gabxelz/EXSU-620---P1---Blood-in-the-drain/docs/photos/README.md

# Build log (photos)

Photos the team took while building the Drain Optics bench prototype, in build order.

| # | Photo | What it shows |
|---|---|---|
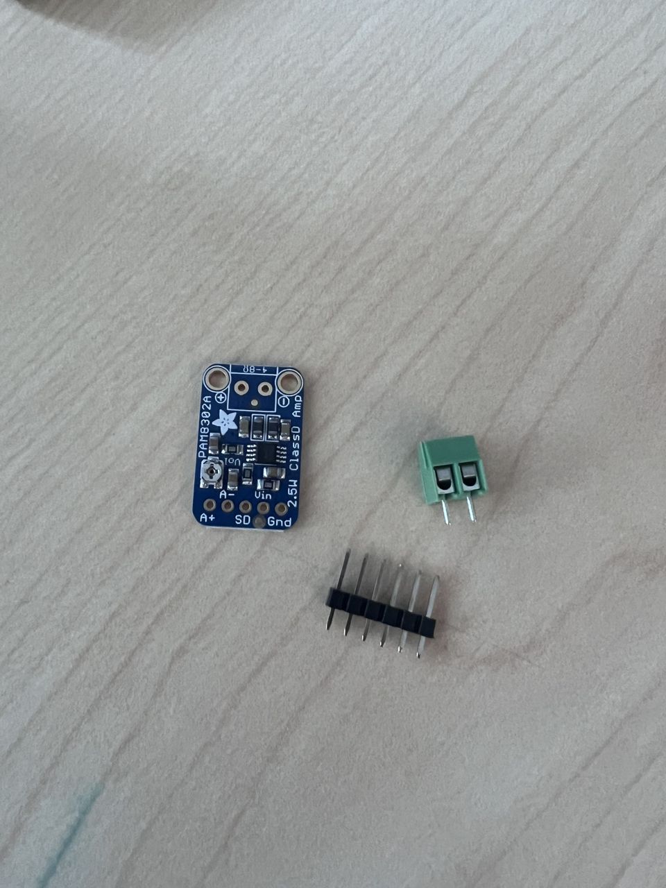
[picture p4: docs/photos/01-pam8302-amp-parts.jpg]
| 1 |  | PAM8302 amplifier as it comes in the kit, with its screw terminal and header pins before soldering. |
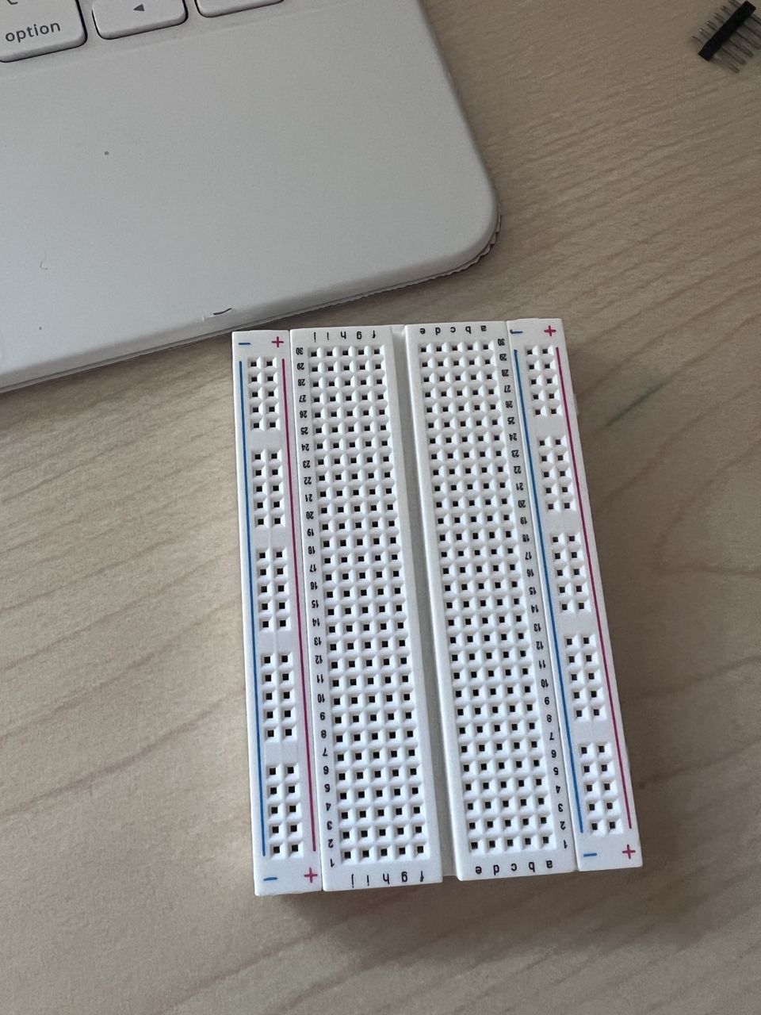
[picture p5: docs/photos/02-breadboard.jpg]
| 2 |  | The half-size breadboard used for power rails, the LED resistor, the button and the amp. |
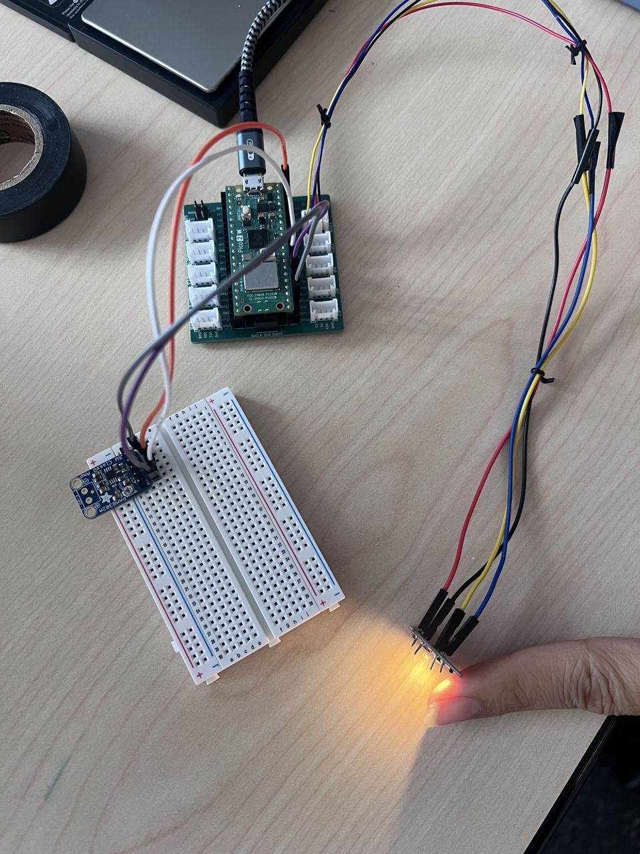
[picture p6: docs/photos/03-first-wiring-led-test.jpg]
| 3 |  | First wiring: Pico 2 W on the Grove shield, colour sensor on jumpers, white LED lit for a light test. |
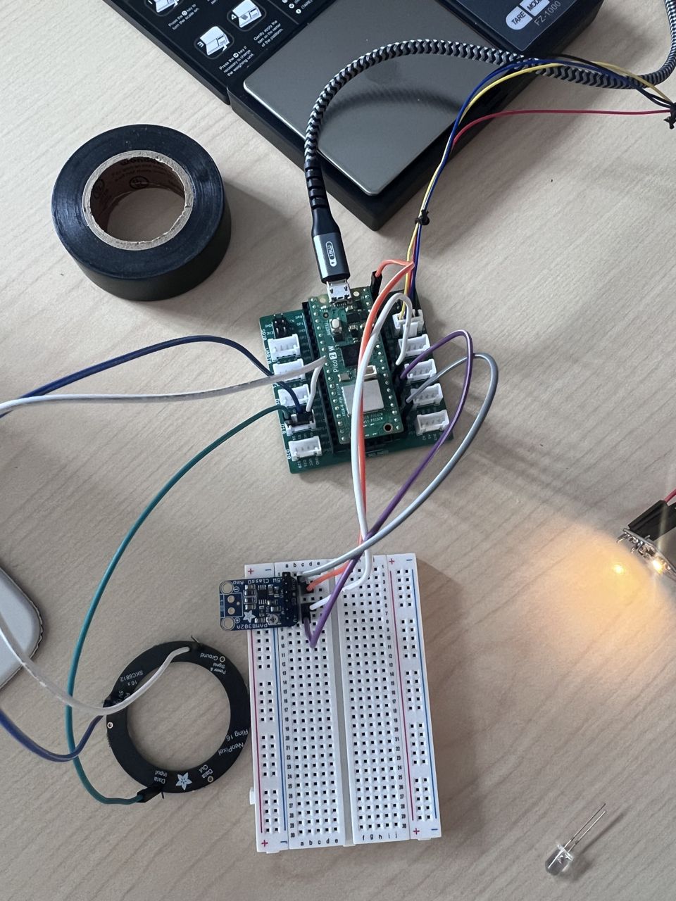
[picture p7: docs/photos/04-pico-sensor-ring-wired.jpg]
| 4 |  | Pico, colour sensor and NeoPixel ring wired together on the bench. |
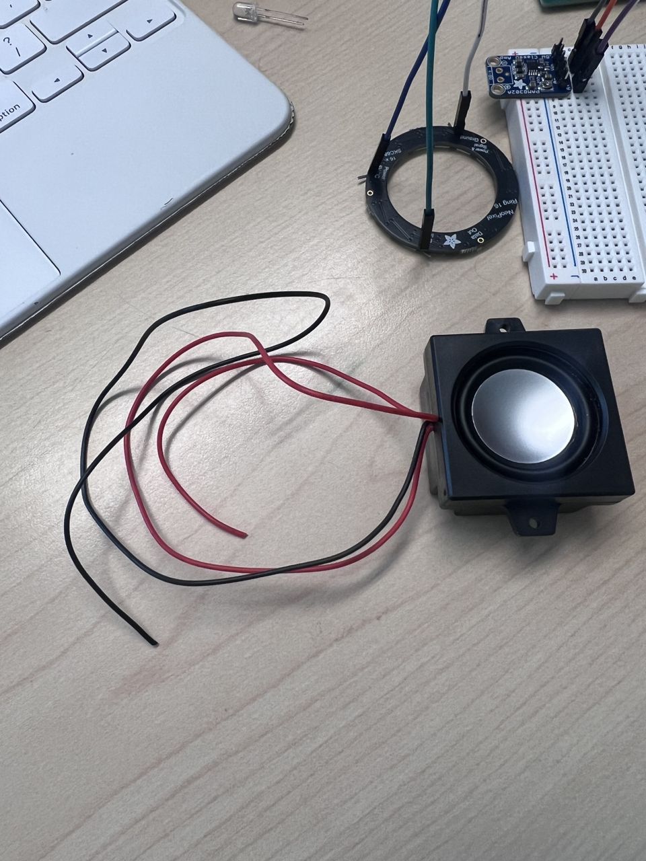
[picture p8: docs/photos/05-speaker-and-neopixel-ring.jpg]
| 5 |  | 8 Ω speaker with its leads, next to the NeoPixel Ring 16 used for the alarm light. |
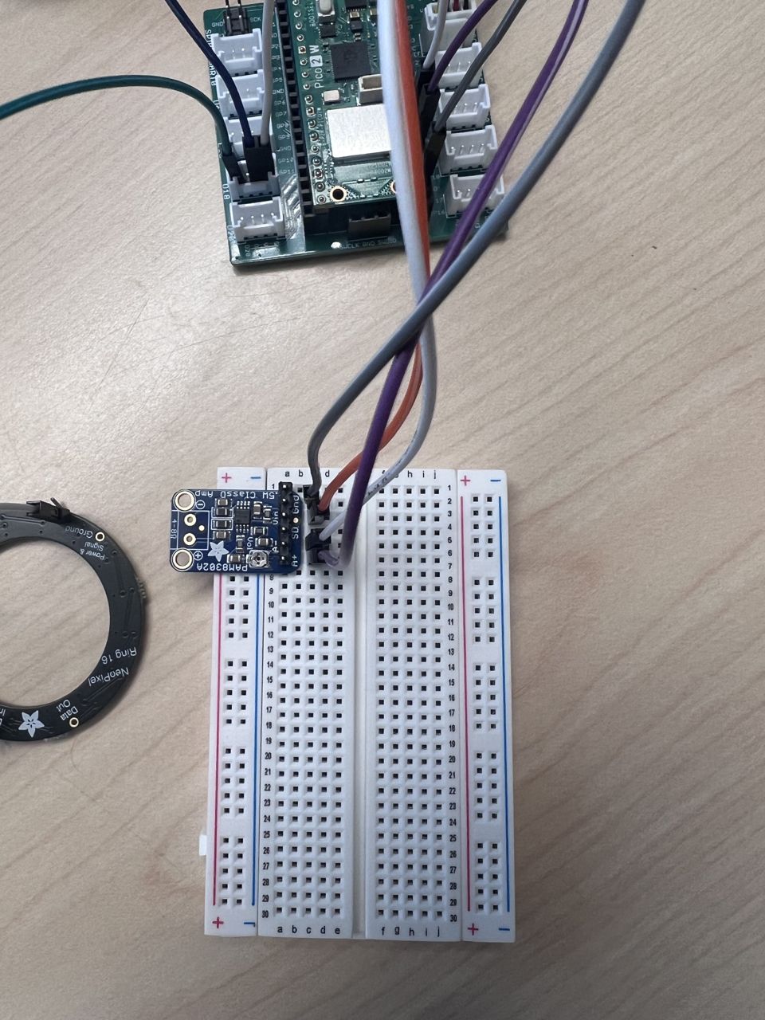
[picture p9: docs/photos/06-amp-on-breadboard.jpg]
| 6 |  | PAM8302 amp placed on the breadboard. |
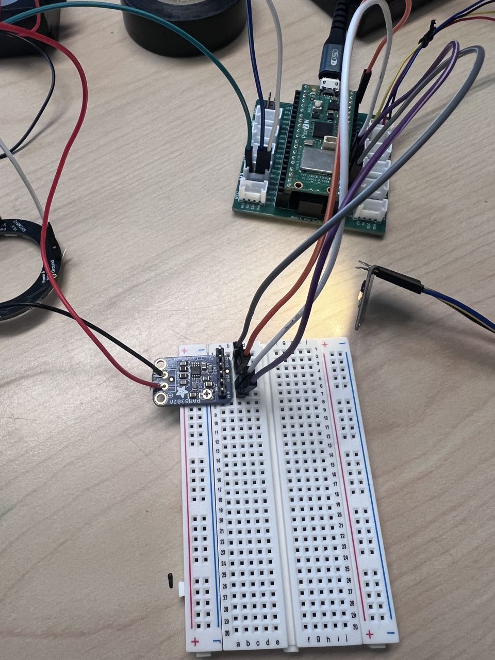
[picture p10: docs/photos/07-amp-wired-to-pico.jpg]
| 7 |  | Amp wired to the Pico: A+ to GP20, Vin to VBUS, grounds to the rail. |
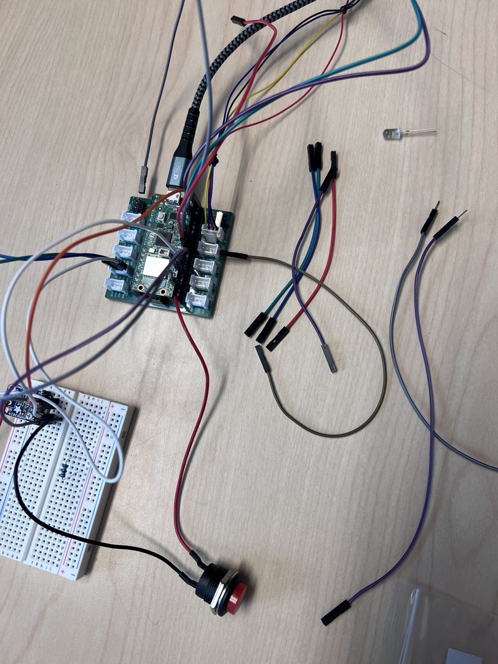
[picture p11: docs/photos/08-ack-button-and-led-wiring.jpg]
| 8 |  | Acknowledge button (GP16 to GND) and white LED leads added. |
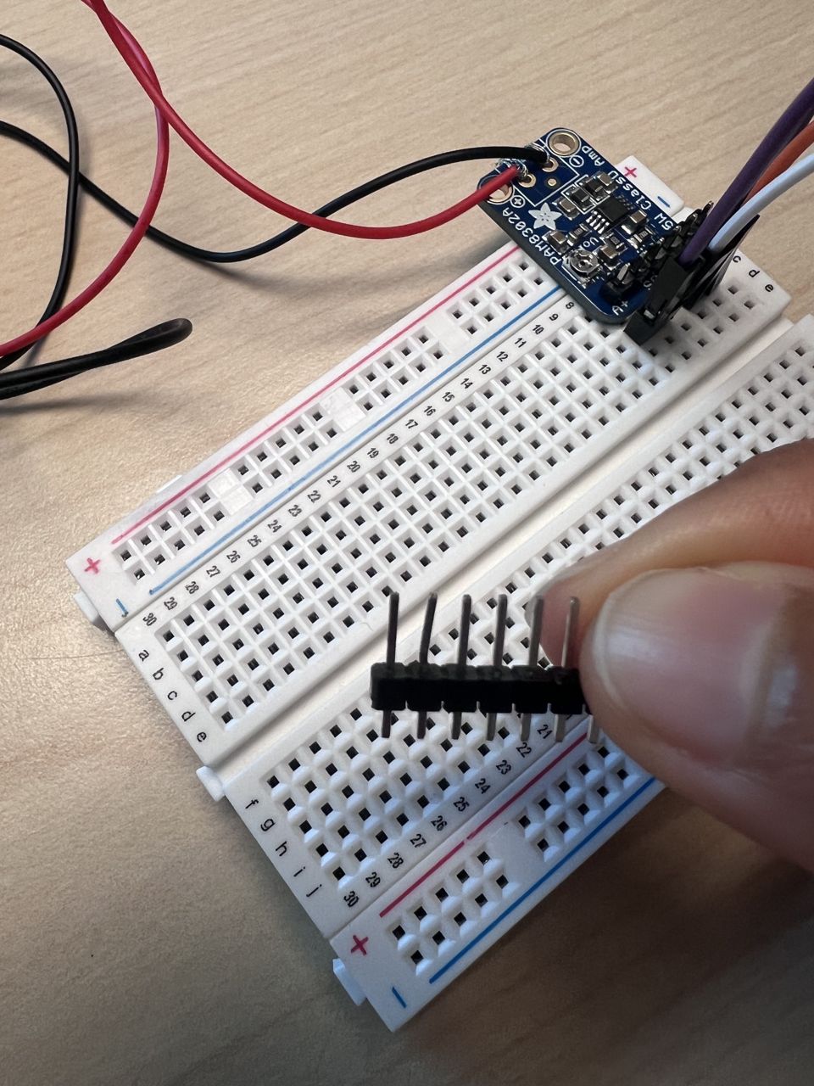
[picture p12: docs/photos/09-soldering-amp-header.jpg]
| 9 |  | Fitting the header pins to the amp for soldering. |
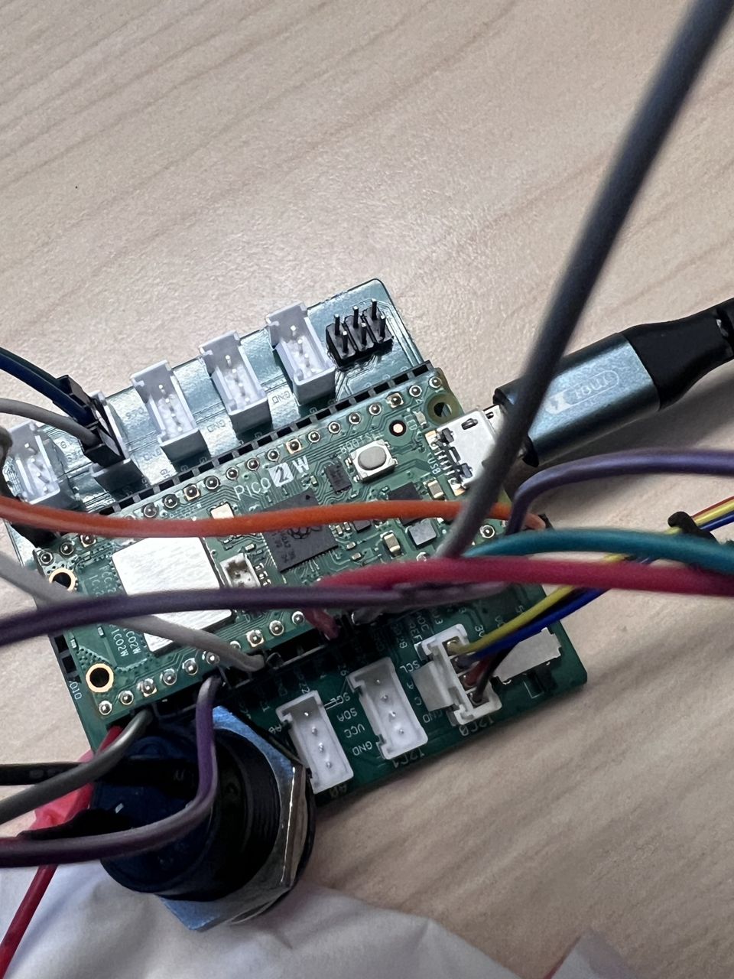
[picture p13: docs/photos/10-pico-grove-shield-closeup.jpg]
| 10 |  | Close-up of the Pico 2 W on the Grove shield with all leads plugged in. |
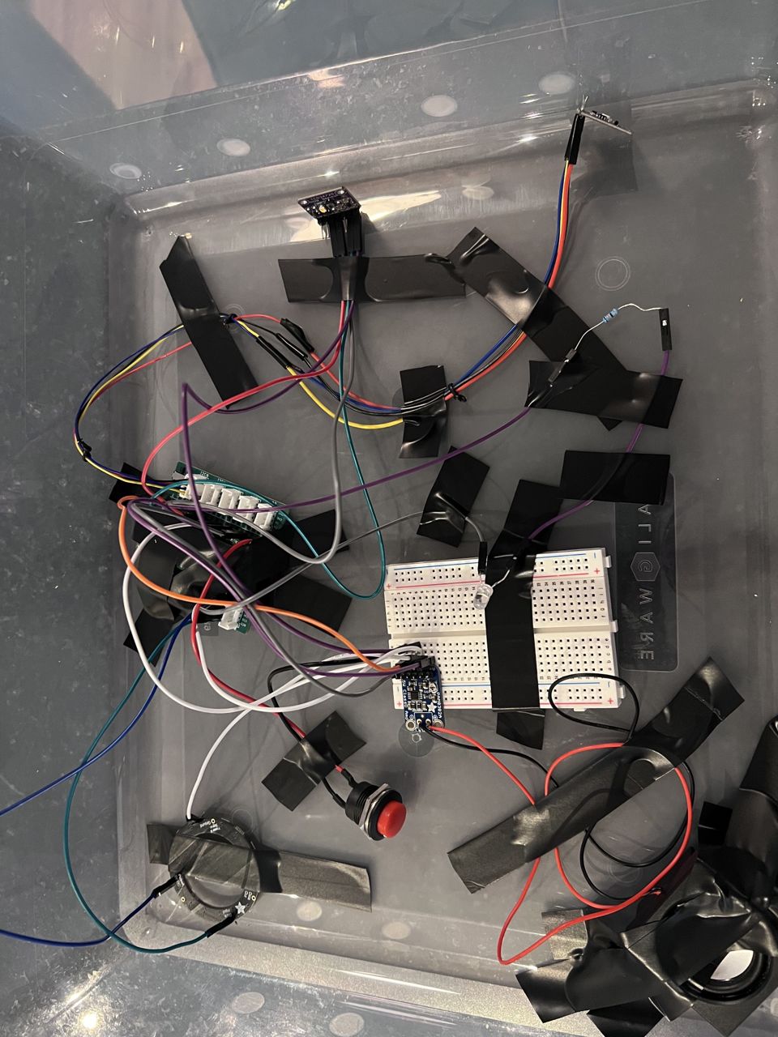
[picture p14: docs/photos/11-parts-in-test-box.jpg]
| 11 |  | Everything taped inside a clear test box before the printed case. |
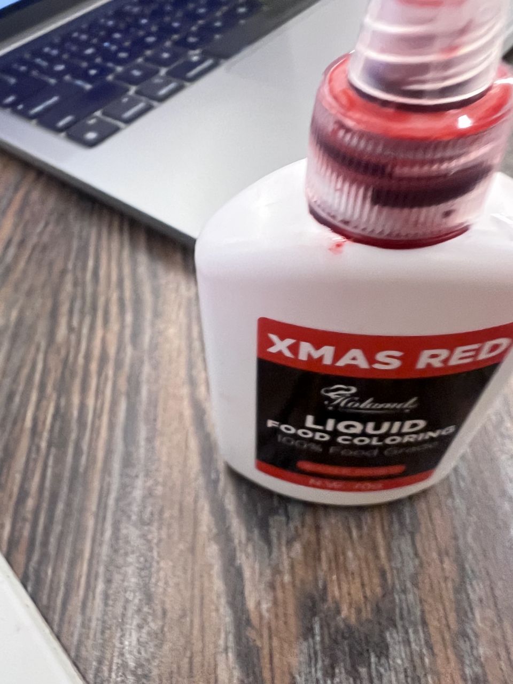
[picture p15: docs/photos/12-red-food-colouring.jpg]
| 12 |  | Red food colouring used as the blood stand-in for the calibration mixes. |
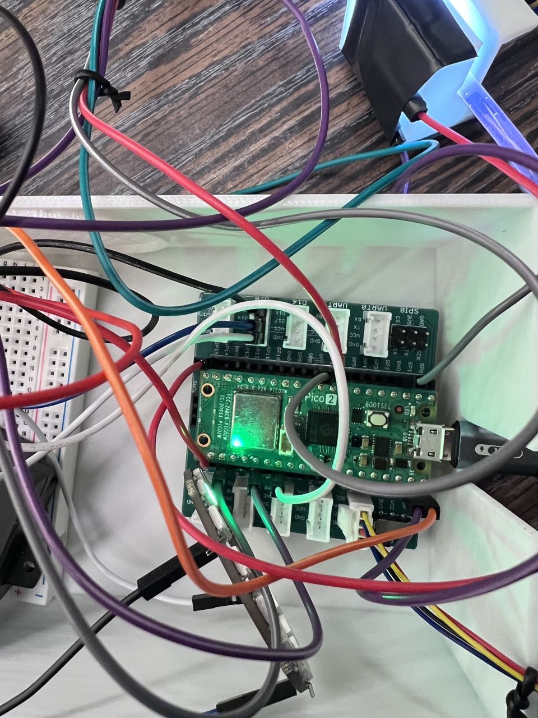
[picture p16: docs/photos/13-final-wiring-powered.jpg]
| 13 |  | Final wiring powered over USB in the case. |
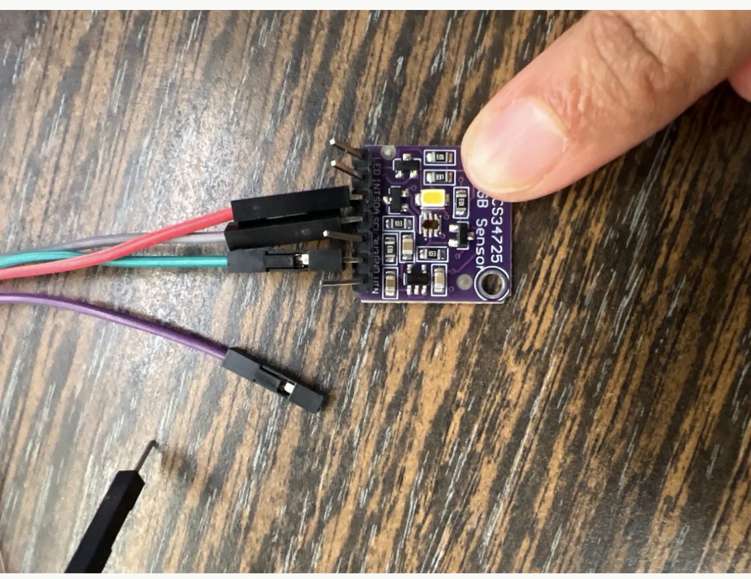
[picture p17: docs/photos/14-tcs34725-sensor.jpg]
| 14 |  | TCS34725 colour sensor with its jumper leads. |
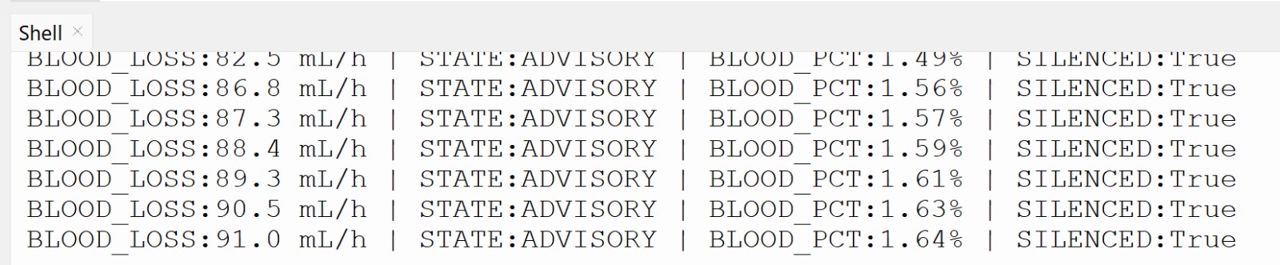
[picture p18: docs/photos/15-serial-output-advisory.jpg]
| 15 |  | Serial output in Thonny during a bench run: about 1.5 % blood, ADVISORY state, alarm silenced by the button. This run used the team's earlier script, which turns % blood into mL/h with a fixed factor rather than a measured flow. |
| 16 |  | Full bench rig: dyed fluid running through the IV tubing and the printed tube clip (right), electronics in the printed case, NeoPixel ring red for CRITICAL. |
| 17 |  | Software group's dashboard (`localhost:5000`): live blood-loss chart in mL/h, blood concentration (1.91 %) and alarm-silence status. |
| 18 |  | Notification path: the DrainOptics Telegram bot sends a CRITICAL alert (103.7 mL/h, 1.87 % blood) to a registered phone. |

## Videos

- [`../videos/demo-device-normal-to-advisory.mp4`](../videos/demo-device-normal-to-advisory.mp4) (56 s): the monitor script running in Thonny, the sensor clip on the tubing, and the output moving from NORMAL to ADVISORY with the ring and speaker responding. Audio is filtered so only the alarm beeps remain (from about 0:30).
- [`../videos/demo-dashboard-live.mp4`](../videos/demo-dashboard-live.mp4) (17 s): the live dashboard on the laptop updating as the fluid in the tube changes.
