gabxelz/EXSU-620---P1---Blood-in-the-drain/report/Blood_in_the_Drain_EXSU620_Report_filled.docx

Drain Optics: Blood in the drain, measured

Group 1

EXSU620

Device

Measurand: Light Absorbance

Reference: Pocket scale, 0.1 g

Status: bench prototype (dyed-water phantom), two-sensor build running monitor_2sensor.py; verification tests in progress.

Section 1: Clinical Requirements, as issued

ID | Requirement
CR-1 | Blood loss through the drain shall be reported as a quantity in millilitres per hour, not as a colour word, and updated at least once a minute
CR-2 | The surgical team shall be alerted when the estimated loss rate exceeds 100mL per hour, or doubles within 30 minutes, whichever happens first
CR-3 | A fouled optical window, an empty line or a failed lamp shall never present as low blood loss
CR-4 | Every shift shall have a cumulative loss figure and a rate trend available at handover and at ward round

Section 2: Engineering Requirements

ID | Traces to | Requirement | Acceptance Criteria
ER-1 | CR-1, CR-3 | Optical reading is stable and immune to room light: room lights on/off and a phone torch at 30 cm change the reading by less than 0.1 % blood. | 5 trials per light condition with clear water and a 1 % mix: every change < 0.1 % blood.
ER-2 | CR-1 | Estimate drain flow in mL/h by counting drops in the drip chamber; range 30-600 mL/h (10-200 drops/min at 20 drops/mL), averaged over 60 s, accuracy ±10 %. | 3 clamp settings x 3 runs of 5 min: mean flow within ±10 % of the weighed collection (1 g = 1 mL).
ER-3 | CR-1 | Report blood loss rate in mL/h (% blood / 100 x flow), and refresh it at least once every 60 s. | Output at least 1 line/s; step from clear water to a 1 % mix reaches 90 % of final value within 60 s, 3 of 3 trials.
ER-4 | CR-2 | Raise an advisory when the estimated rate stays above 100 mL/h for 5 min (amber ring, 3 pulses); clear after 10 min below. | Replayed and live scenarios: advisory raised within 60 s of the 5-min condition, 5 of 5; no alarm in 30 min below 80 mL/h.
ER-5 | CR-2 | Raise a critical alarm when the rate at least doubles within 30 min (red ring, 10 pulses), latched until acknowledged and back in range. | Doubling scenario 5 times: critical raised within 60 s, 5 of 5; stays latched until ack press and rate back in range.
ER-6 | CR-3 | Technical alarm (never low blood loss) for: static line (no drop for 10 s), failed lamp, empty/air-filled tube, saturation and fouled window; raised within 15 s. | Clamp shut 10 times and each optical fault induced 5 times: 100 % shown as a technical alarm within 15 s; 0 false alarms in 30 min at 30 mL/h.
ER-7 | CR-1 | Blood concentration from the green/red ratio: range 0-2 % blood (dye analogue), one reading every ≤ 0.25 s, accuracy ±0.25 % blood. | 3 blind mixes (0.5, 1.0, 1.5 %), 3 readings of 30 s each: every mean within ±0.25 % of the true value.
ER-8 | CR-4 | Log every reading with a timestamp; give cumulative blood volume for the shift (±15 %) and a rate trend of the last 12 h. | 1 h run with a known mix: logged cumulative blood within ±15 % of collected volume x known %; trend shows the full hour.

Section 3: System Design

Architecture, sensing approach, alarm rules, data model, and the alternatives that were rejected and why

Option Considered | Decision | Reason
One colour sensor with a hand-entered flow | Rejected | Colour alone cannot give mL/h: a slow, very bloody drain and a fast, lightly bloody one look the same; a typed flow goes stale when the clamp moves.
Second TCS34725 counting drops in the drip chamber | Chosen | Gives live flow in mL/h from the IV set's drop factor, and a missing drop is a direct test for a clotted or empty line (CR-3). Same kit sensor.
Pocket scale under the bag as the live flow channel | Rejected | The project card forbids the reference instrument as a live channel; the scale is used only for dilutions and flow checks.
Cuvette holder (sample taken off the line) | Rejected | Needs manual sampling, so no continuous reading; replaced by a printed flow-through tube clip.
NeoPixel pixel as the light source | Rejected | The ring is the alarm indicator; a separate white LED on GP15 lights the tube.
I2C multiplexer for two sensors with the same address (0x29) | Rejected | Not in the kit; sensor 2 runs on its own software I2C bus (GP6/GP7).
Change in absorbance per minute from one sensor as the rate | Rejected | Measures how fast the colour changes, not how much fluid flows; reads 0 for steady bleeding.

Section 4: Component, module and system chart

Components grouped into modules, every interface named with its signal, direction and range

Section 5: Interfaces

ID | Between | Signal and Protocol | Kind
IF-1 | Sensor 1 (tube clip) -> Pico | I2C0, GP8 SDA / GP9 SCL, 100 kHz, address 0x29; R, G, B, C counts 0-65 535 per 101 ms | Digital, input
IF-2 | Sensor 2 (drip chamber) -> Pico | Software I2C, GP6 SDA / GP7 SCL, 400 kHz, address 0x29; clear counts 0-65 535, polled every ~3 ms | Digital, input
IF-3 | Pico -> white LED | GP15, low = on; VBUS -> 330 Ω -> LED -> GP15; about 3-6 mA | Digital output / power
IF-4 | White LED -> sensor 1 | Light through the Ø4.4 tube channel and Ø3.5 window | Optical
IF-5 | Pico -> NeoPixel ring | GP18 single-wire data, 800 kHz, 5 V from VBUS; 16 x RGB 0-255 (used ≤ 30) | Digital output
IF-6 | Pico -> PAM8302 -> speaker | GP20 PWM tone 500-1000 Hz into A+; amp drives 8 Ω speaker (up to 2.5 W) | PWM / audio
IF-7 | Ack button -> Pico | GP16 input, internal pull-up; 1 = released, 0 = pressed | Digital, input
IF-8 | Pico <-> laptop | USB CDC serial, one text line per reading (~5 lines/s): blood %, drops/min, flow, blood rate, state, silenced; USB 5 V power ≤ 500 mA | Data + power
IF-9 | Drip chamber -> tube clip | Gravity flow through IV tubing (~4.1 mm OD), 0-600 mL/h on the bench | Fluid

Section 6, Deliverable D4: System diagrams

Four diagrams required: Block diagram, wiring diagram, alarm state chart, and the sequene diagram from sample to notification

Section 7, Deliverable D5: Implementation

Section 8, Deliverable D6: Verification plan

Requirement | Method | Apparatus | Sample | Acceptance
ER-1 | Switch room lights on/off, shine a torch at 30 cm; read % blood | Rig, phone torch, serial log | 5 per condition, clear water and 1 % mix | Change < 0.1 % blood
ER-2 | Timed 5-min collection vs counted flow | Rig, cup, 0.1 g scale, stopwatch | 3 clamp settings x 3 runs | Within ±10 %
ER-3 | Switch bag from clear water to a 1 % mix at fixed flow; time the reported rate | Rig, serial log, stopwatch | 3 steps | 90 % of final value within 60 s
ER-4 | Feed recorded rate files (steady 50 mL/h; 120 mL/h for 6 min) to the rules, then live | Laptop, recorded logs, rig | 5 runs + 30 min below 80 mL/h | Advisory within 60 s, 5/5; no false alarm
ER-5 | Recorded and live doubling of the rate within 30 min; press ack | Laptop, recorded logs, rig | 5 runs | Critical within 60 s, 5/5; latched until ack and back in range
ER-6 | Shut the clamp; unplug LED; drain tube; torch into clip; smear window | Rig, phone torch, grease pen, stopwatch | 10 clamp closures + 4 faults x 5 | 100 % detected within 15 s; 0 false alarms in 30 min
ER-7 | Blind mixes made by a second person, read in shuffled order after 1 min flush | Rig, 0.1 g scale, dye stock, syringes | 3 mixes x 3 readings of 30 s | Each mean within ±0.25 % blood
ER-8 | 1 h unattended run with a known mix; compare logged total with cup volume x known % | Rig, laptop service, cup, scale | 1 run of 1 h | Within ±15 %; log complete; trend shows the hour

Section 9, Deliverable D7: Verification report

Section 10, Deliverable D8: Failure modes and mitigation

ID | Failure Mode | Effect | S | O | D | RPN | Mitigation | Status
FM-1 | Drain line blocked (clot, kink or clamp shut) | Flow stops; looks like bleeding has stopped | 5 | 3 | 2 | 30 | Check-drain technical alarm: blue ring + beep pattern when no drops for 10 s (or reading frozen 60 s with one sensor) | Implemented; test pending
FM-2 | White LED fails or its lead comes loose | Less light reaches the sensor; can read as wrong blood level | 5 | 2 | 3 | 30 | No-light alarm when sensor 1 clear channel < 10 counts | Partly: only total darkness caught
FM-3 | Optical window fouled (film, dried blood, condensation) | Reads redder or darker than true | 4 | 3 | 4 | 48 | g/r ratio cancels part of it; add red-reference window check | Not implemented
FM-4 | Air bubbles or empty tube in the clip | Jumpy or no valid reading | 4 | 3 | 2 | 24 | No-light alarm for an empty tube; 5-reading average smooths bubbles | Implemented
FM-5 | Room light or a torch leaks into the clip | False concentration | 3 | 3 | 3 | 27 | Black PLA clip wrapped in black tape; dark reading between samples planned | Partly
FM-6 | Sensor saturates (bright light or gain too high) | Ratio meaningless, may read as clear | 4 | 2 | 3 | 24 | Gain fixed at 1x; add saturation check (any channel ≥ 60 000) | Not implemented
FM-7 | Tube moves or is not seated in the clip | Light path changes; wrong % blood | 4 | 3 | 3 | 36 | Push-in slit holds the tube; clip taped; recalibrate after any change | Implemented
FM-8 | Blood concentration above the calibrated range (> 2 %) | Extrapolated reading, poor accuracy | 4 | 2 | 3 | 24 | Extend the dilution series; flag readings above 2 % | Not implemented
FM-9 | Wrong flow value (drop factor wrong or entered flow out of date) | Blood loss rate wrong by a fixed ratio | 4 | 3 | 4 | 48 | Check flow by timed 5-min collection; set DROP_FACTOR / FLOW_MLH | Not verified
FM-10 | Sensor cable unplugged or I2C read error | Script stops; reading freezes | 5 | 2 | 2 | 20 | Catch read errors and switch to a technical alarm; laptop sees lines stop | Not implemented
FM-11 | Pico crashes or loses USB power | Device silent; no alarm at all | 5 | 2 | 3 | 30 | Script saved as main.py so it restarts at power-up; watchdog timer planned | Partly
FM-12 | Speaker or amplifier fails, or volume too low | Alarm not heard | 4 | 2 | 3 | 24 | Light ring alarms at the same time; VOLUME and amp screw adjustable; start-up beep test planned | Partly
FM-13 | NeoPixel ring fails or is too dim | Visual alarm missed | 3 | 2 | 3 | 18 | Speaker alarms at the same time; ring under translucent cap | Implemented
FM-14 | Alarm silenced and forgotten | Missed escalation | 4 | 3 | 2 | 24 | Silence lasts only 2 min; a new or worse alarm sounds at once | Implemented
FM-15 | Ack button stuck down or shorted | Sound stays silenced | 4 | 1 | 3 | 12 | Require button release between presses; show silenced state on the ring | Not implemented

Section 11, Deliverable D9: Traceability and limitations

Clinical Requirement | Engineering Requirements | Evidence | Status
CR-1 | ER-1, ER-2, ER-3, ER-7 | Calibration curve (4 points: A 0.64 / 0.78 / 0.86 = 0.5 / 1 / 2 % blood, baseline g/r 1.3406); firmware prints % blood, flow and blood rate every reading | Implemented; verification tests pending
CR-2 | ER-4, ER-5 | Current firmware alarms on % blood (0.5 % amber, 1.8 % red), not on mL/h; 5-min and doubling rules not yet coded | Not met
CR-3 | ER-1, ER-6 | Static-line alarm after 10 s with no drops; no-light alarm for empty tube; fouled window, saturation and LED dimming not detected | Partly met
CR-4 | ER-8 | Pico sends one line per reading over USB; shift total and trend depend on the laptop service | Not met on the device

Declared limitations

- Bench only: dyed water stands in for blood; real drain fluid scatters light and absorbs differently, so the curve must be repeated before any clinical claim.

- Calibration covers 0-2 % blood from one series of four points; above 2 % the reading is extrapolated.

- Flow assumes 20 drops/mL; the drop factor of our IV set is not printed and is not yet verified.

- The check-drain alarm (10 s without drops) is valid only above about 30 mL/h; slower drains will false-alarm.

- Alarms currently switch on % blood, not on the mL/h rate, and the doubling rule is not implemented (CR-2 not met).

- No dark-frame subtraction or fouled-window check in the MicroPython firmware; room light and dirty windows can bias the reading.

- Firmware is MicroPython rather than the CircuitPython named on the card.
