gabxelz/EXSU-620---P1---Blood-in-the-drain/docs/images/breadboard-layout.png

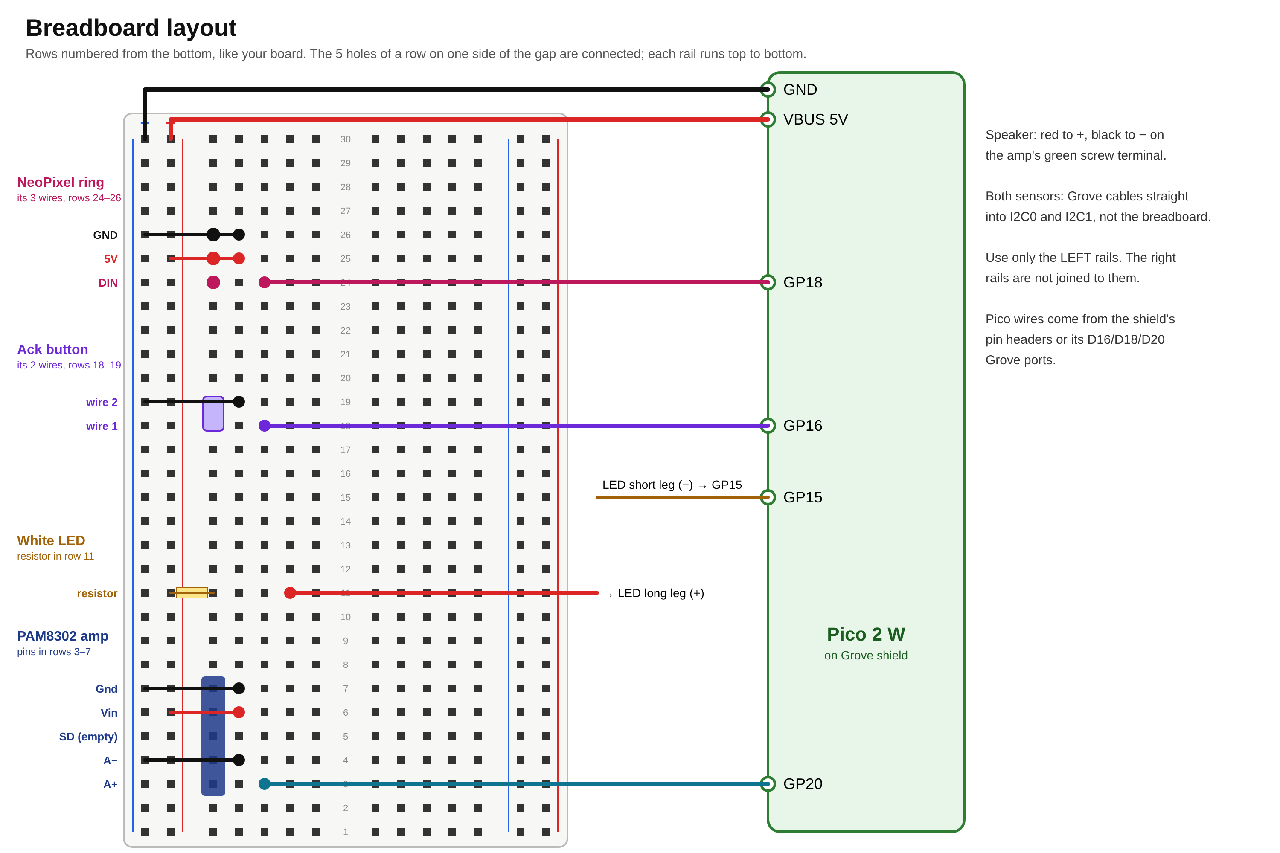
docs/images/breadboard-layout.png
