gabxelz/EXSU-620---P1---Blood-in-the-drain/docs/images/case-v3-2-case-lid-off.png

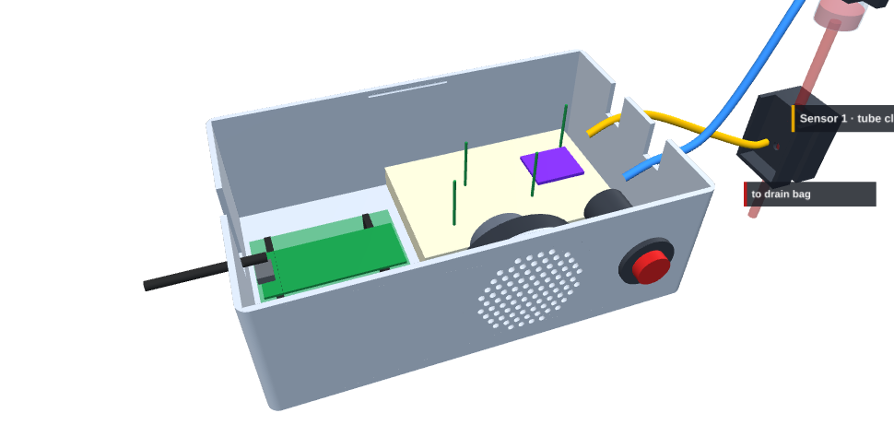
docs/images/case-v3-2-case-lid-off.png
