gabxelz/EXSU-620---P1---Blood-in-the-drain/docs/images/case-v3-3-front-panel.png

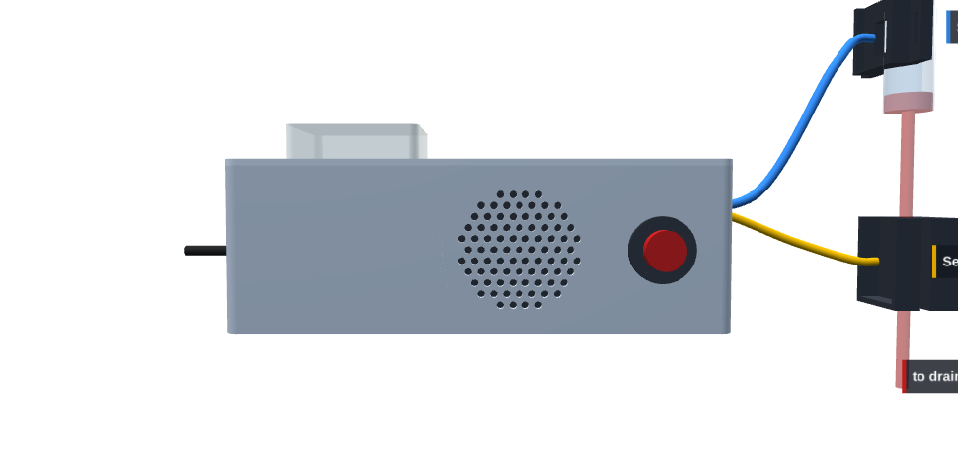
docs/images/case-v3-3-front-panel.png
