gabxelz/EXSU-620---P1---Blood-in-the-drain/docs/images/case-v3-4-lid-underside.png

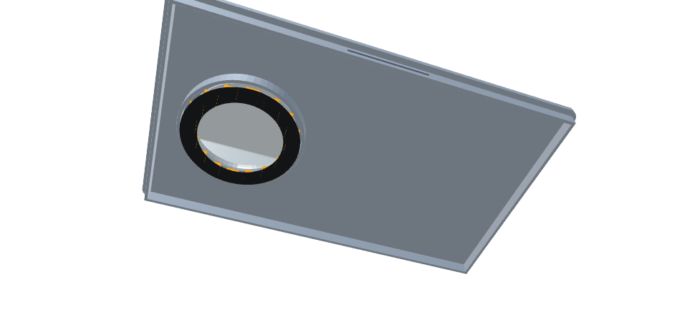
docs/images/case-v3-4-lid-underside.png
