gabxelz/EXSU-620---P1---Blood-in-the-drain/cad/enclosure/T6_caseA_assembly_v1.step

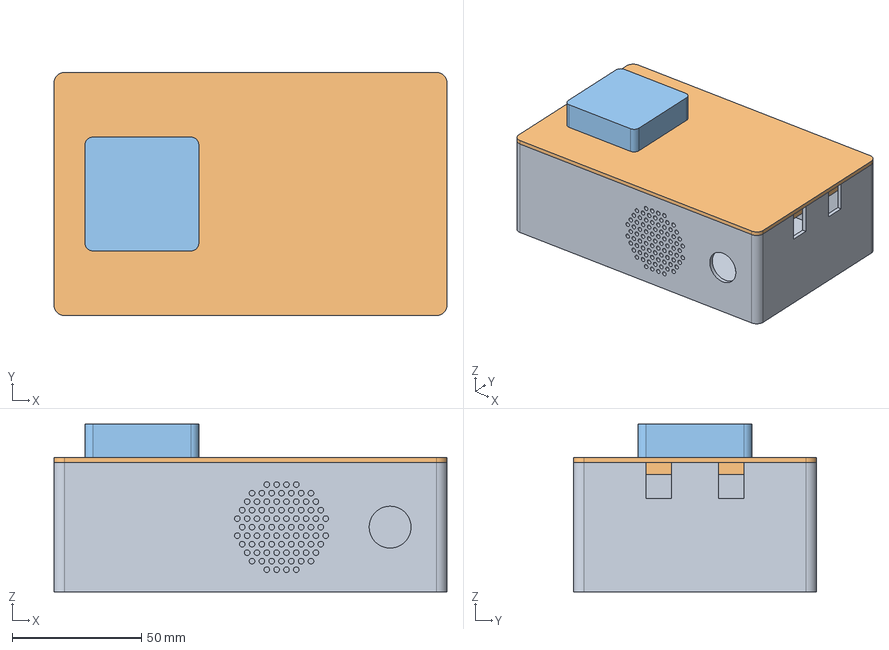
[picture p30: CAD file, 2026-11-04]
cad/enclosure/T6_caseA_assembly_v1.step
152.0 x 94.0 x 64.8 mm
base
lid
light_cap
