gabxelz/EXSU-620---P1---Blood-in-the-drain/cad/tube-clip/DrainOptics_TubeClip_v4.step

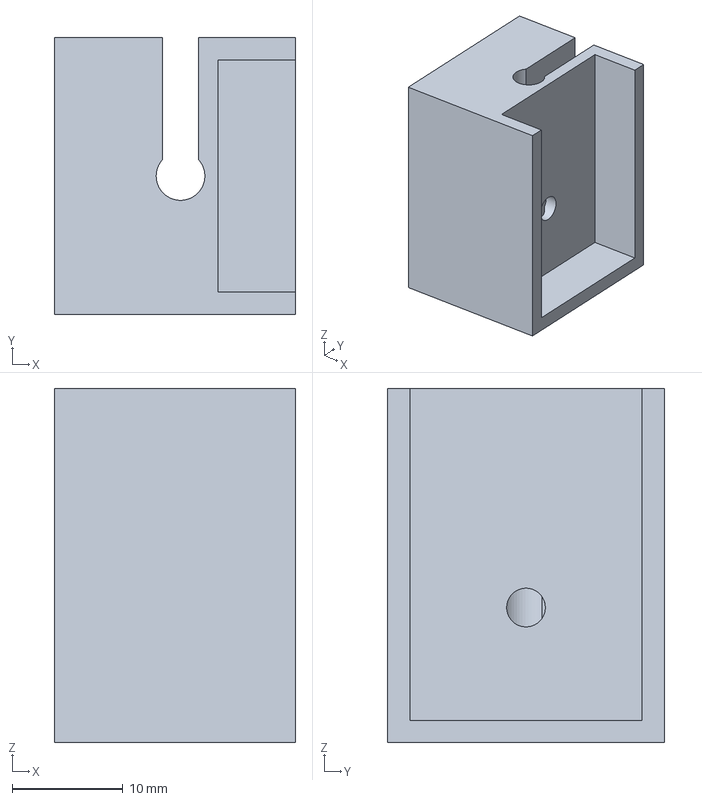
[picture p31: CAD file, 2026-11-04]
cad/tube-clip/DrainOptics_TubeClip_v4.step
21.8 x 25.0 x 32.0 mm
