gabxelz/EXSU-620---P1---Blood-in-the-drain/cad/enclosure/T6_light_cap_v1.step

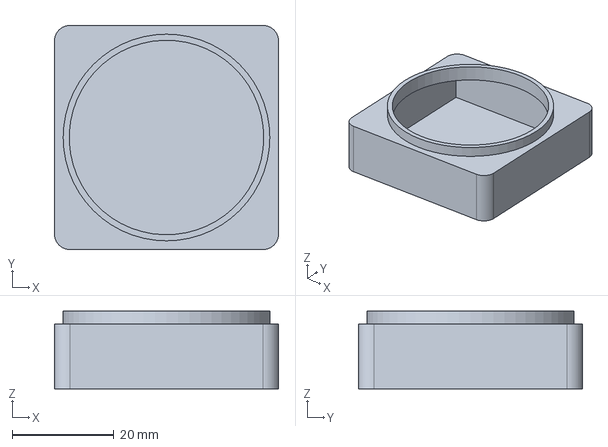
[picture p33: CAD file, 2026-11-04]
cad/enclosure/T6_light_cap_v1.step
44.0 x 44.0 x 15.3 mm
