gabxelz/EXSU-620---P1---Blood-in-the-drain/cad/enclosure/T6_caseA_base_v1.step

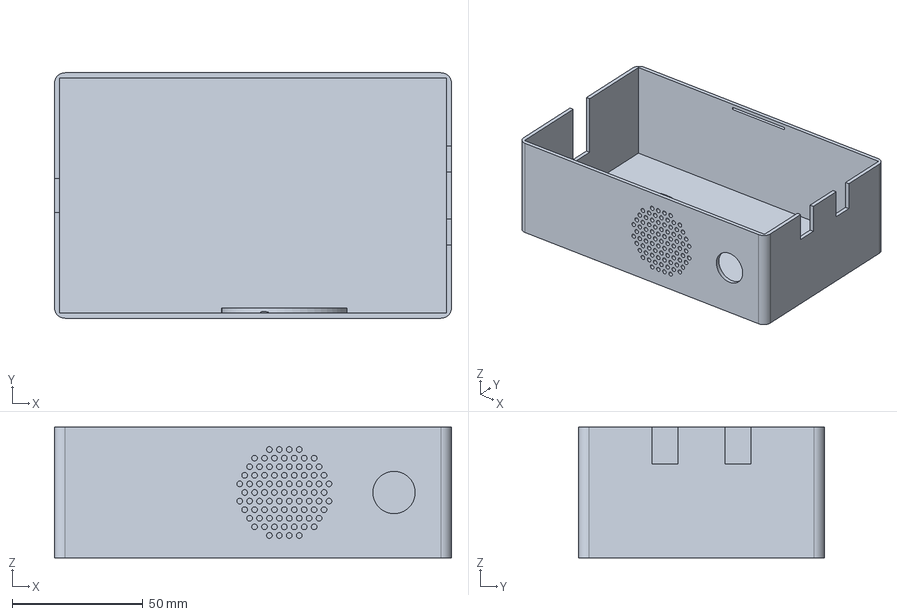
[picture p34: CAD file, 2026-11-04]
cad/enclosure/T6_caseA_base_v1.step
152.0 x 94.0 x 50.0 mm
