gabxelz/EXSU-620---P1---Blood-in-the-drain/(list of files, cad)

Other CAD files:
cad/enclosure/T6_caseA_base_v1.stl
cad/enclosure/T6_caseA_lid_v1.stl
cad/enclosure/T6_light_cap_v1.stl
cad/tube-clip/DrainOptics_TubeClip_v4.stl
