gabxelz/EXSU-620---P1---Blood-in-the-drain/docs/images/case-v3-1-whole-setup.png

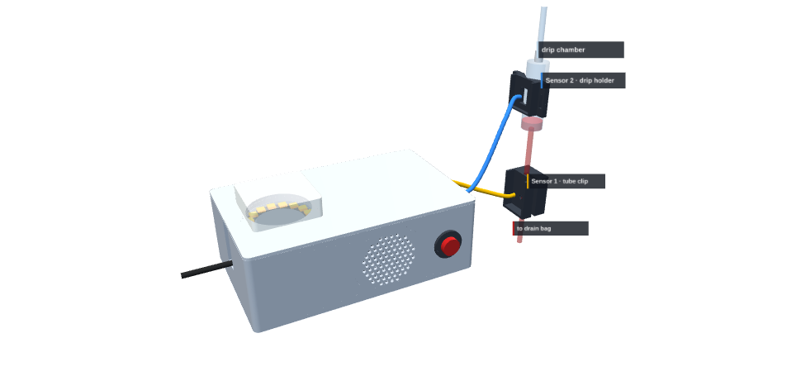
docs/images/case-v3-1-whole-setup.png
