gabxelz/EXSU-620---P1---Blood-in-the-drain/docs/images/full-wiring.png

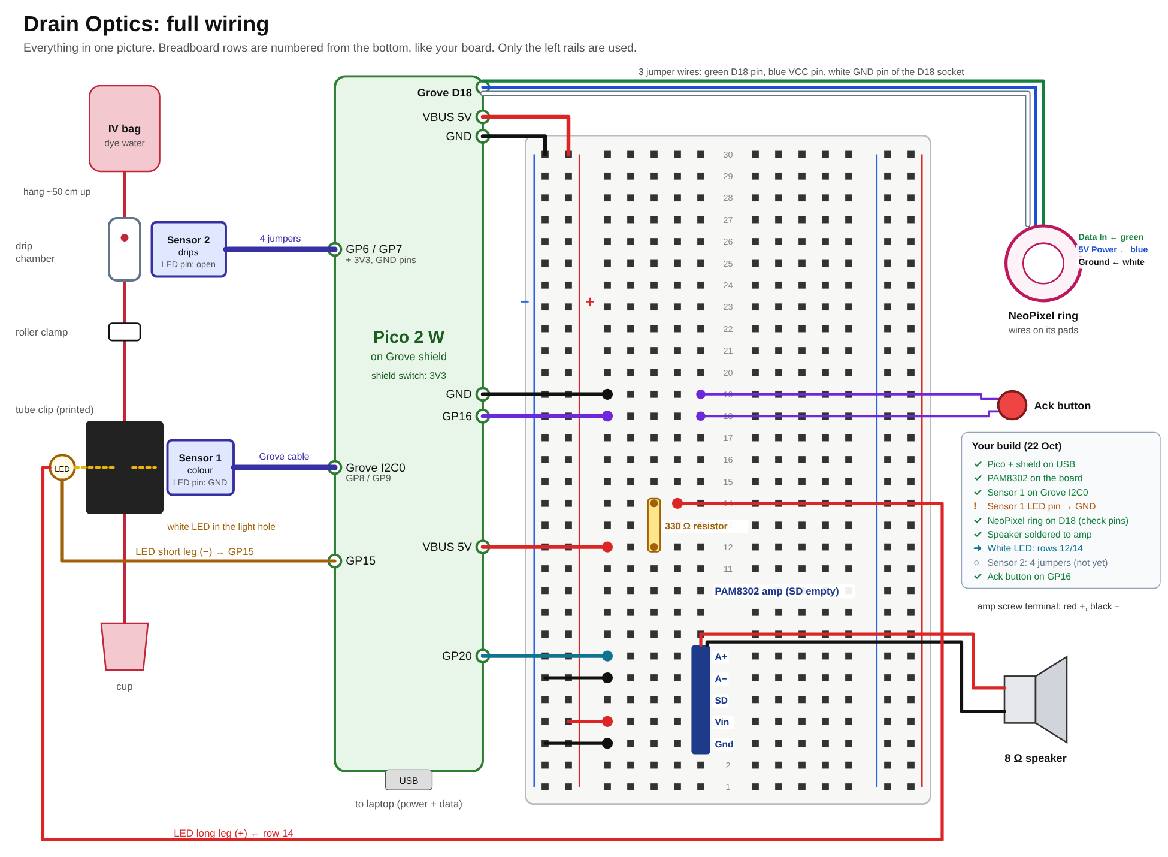
docs/images/full-wiring.png
