gabxelz/EXSU-620---P1---Blood-in-the-drain/docs/images/led-wiring.png

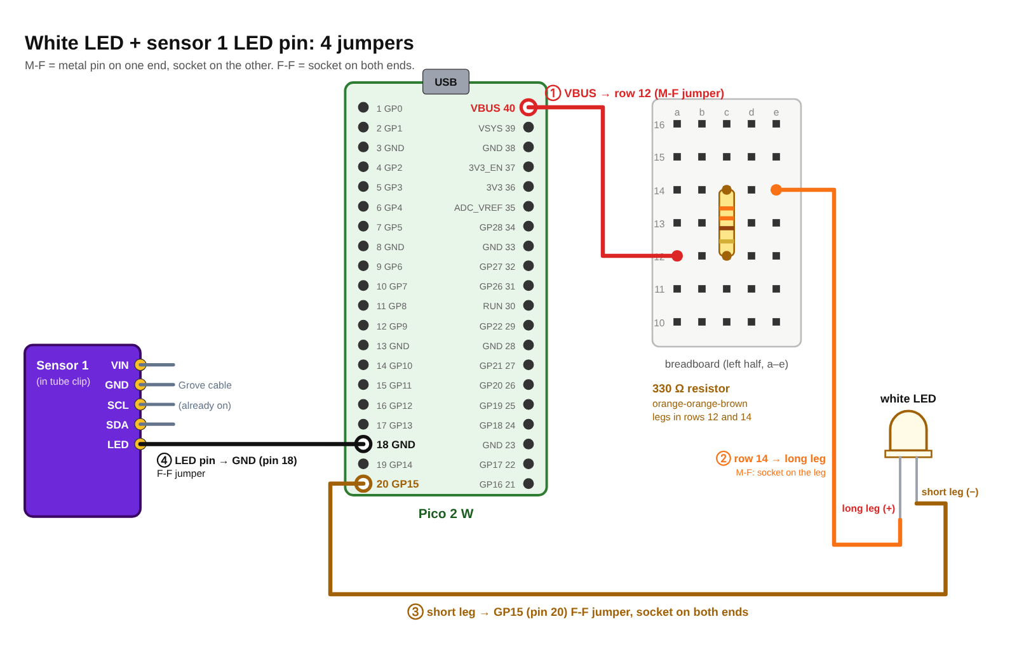
docs/images/led-wiring.png
