gabxelz/EXSU-620---P1---Blood-in-the-drain/docs/images/pam8302-wiring.jpg

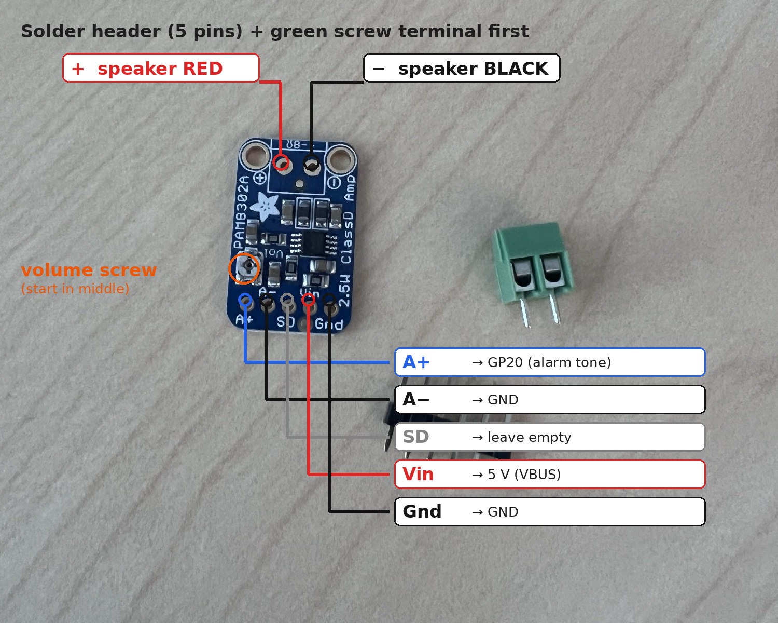
docs/images/pam8302-wiring.jpg
