gabxelz/EXSU-620---P1---Blood-in-the-drain/docs/images/wiring-diagram.png

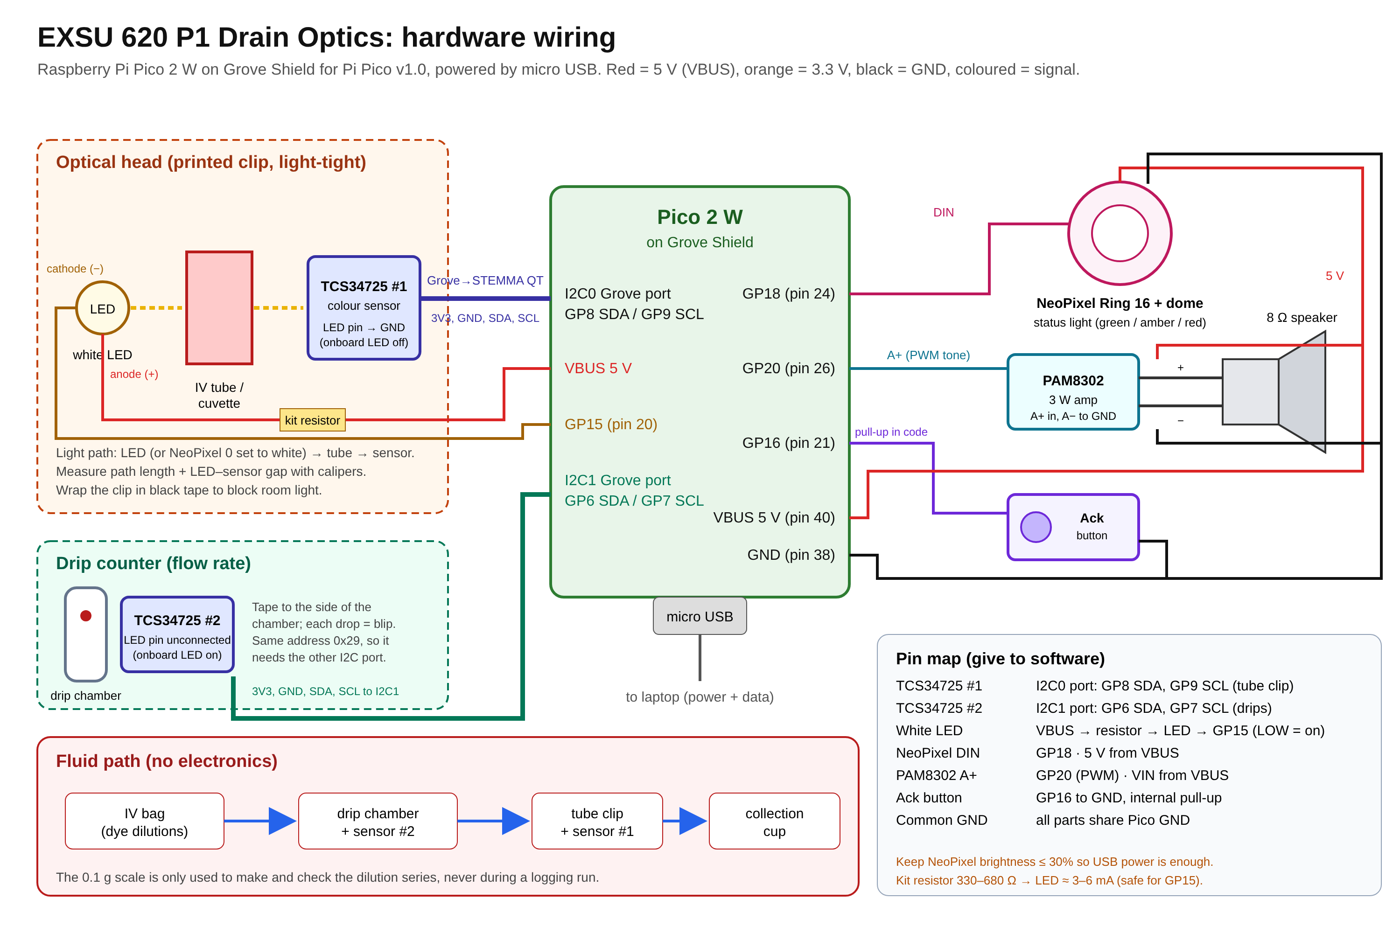
docs/images/wiring-diagram.png
