gabxelz/EXSU-620---P1---Blood-in-the-drain/(commit log)

2026-11-04 Add Drain Optics files
    [DrainOptics_TubeClip_v4.step, DrainOptics_TubeClip_v4.stl, T6_caseA_assembly_v1.step, T6_caseA_base_v1.step, T6_caseA_base_v1.stl, T6_caseA_lid_v1.step, T6_caseA_lid_v1.stl, T6_light_cap_v1.step]
2026-11-04 Updated README with calibrated values
    Updated flow measurement details and alarm states for improved accuracy.
2026-11-04 Modify TCS34725 sensor entry in BOM
    Updated the quantity and description of the TCS34725 RGB colour sensor in the BOM.
